citixen/pt2399_tap_euro/v1.1_control only.pdf

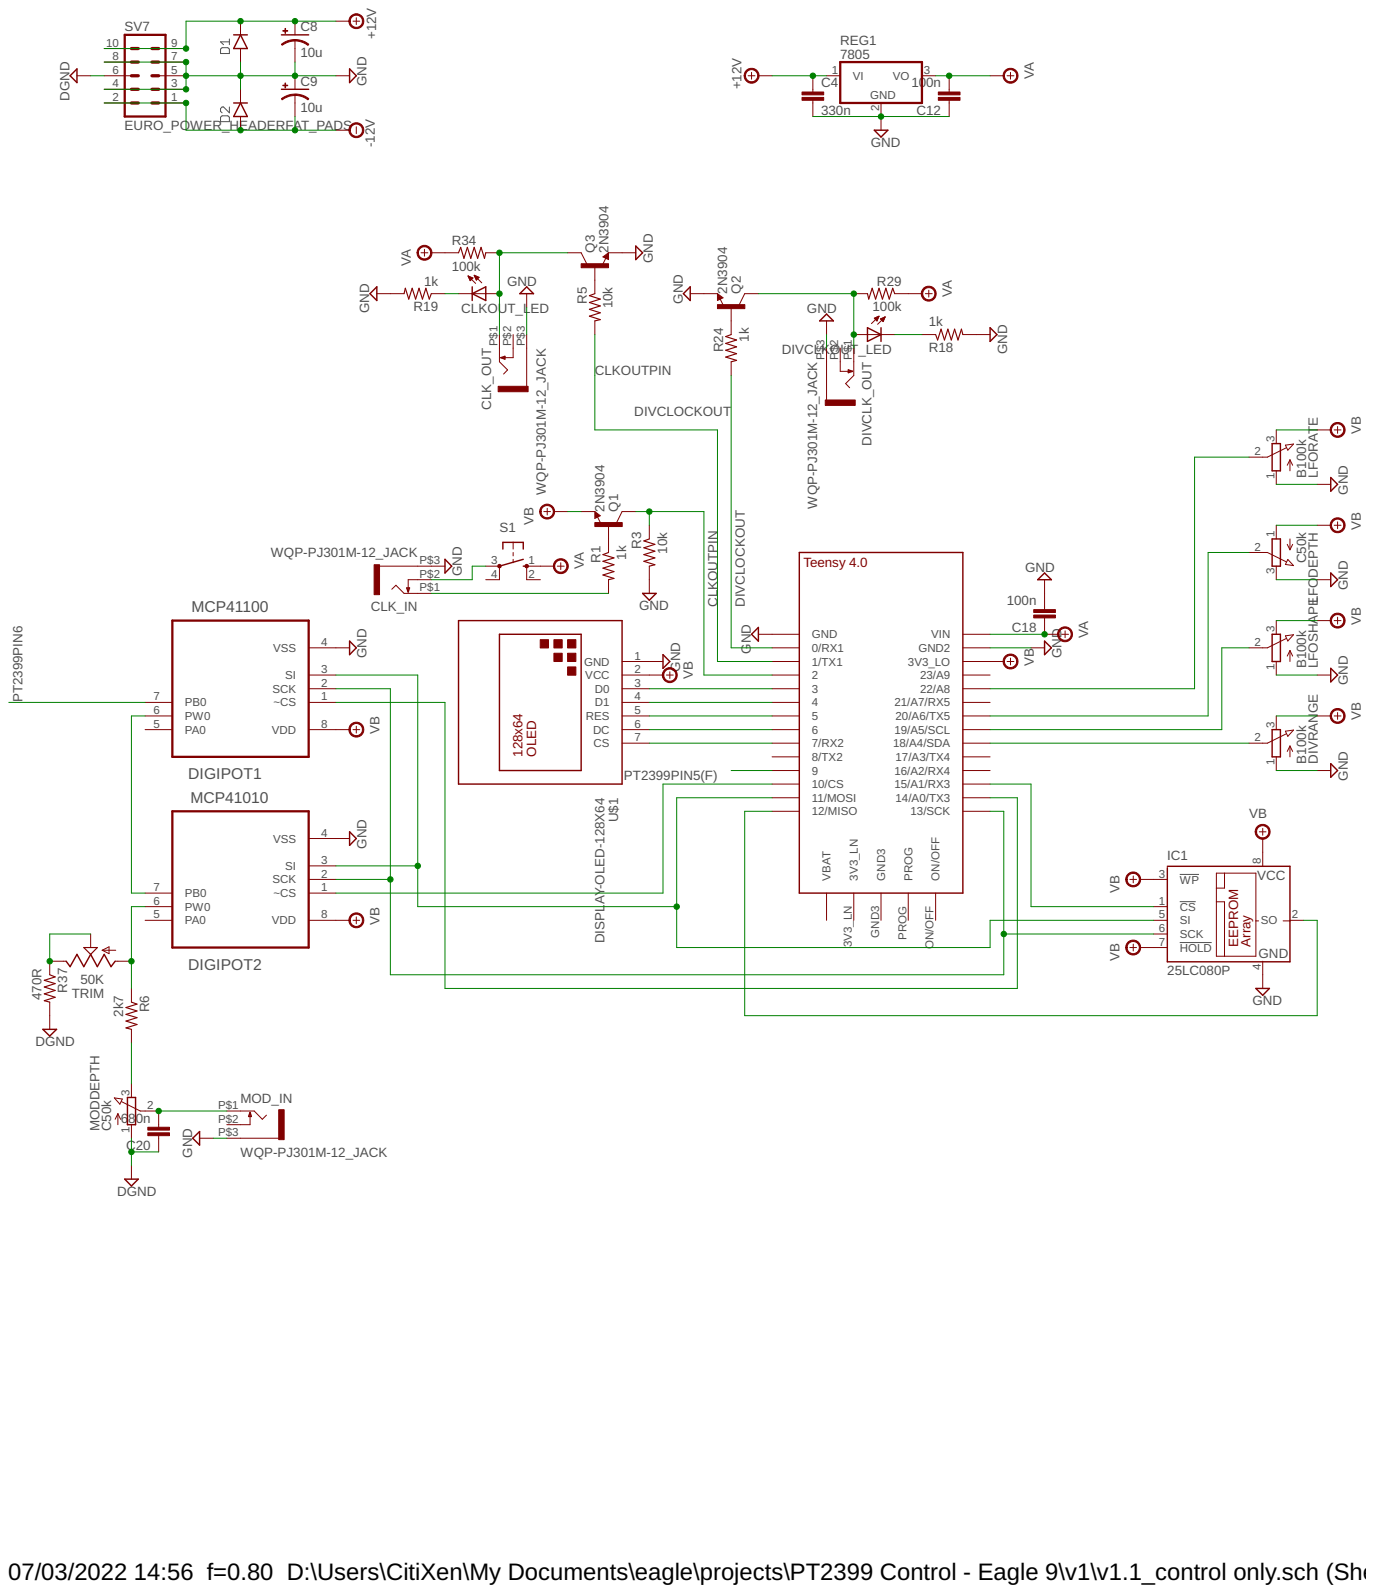
[picture p1: page 1]

ON/OFF

07/03/2022 14:56 f=0.80 D:\Users\CitiXen\My Documents\eagle\projects\PT2399 Control - Eagle 9\v1\v1.1_control only.sch (Sheet: 1/2)
