citixen/pt2399_tap_euro/v1.1_control only.sch

## EAGLE design v1.1_control only.sch (2022-03-07)

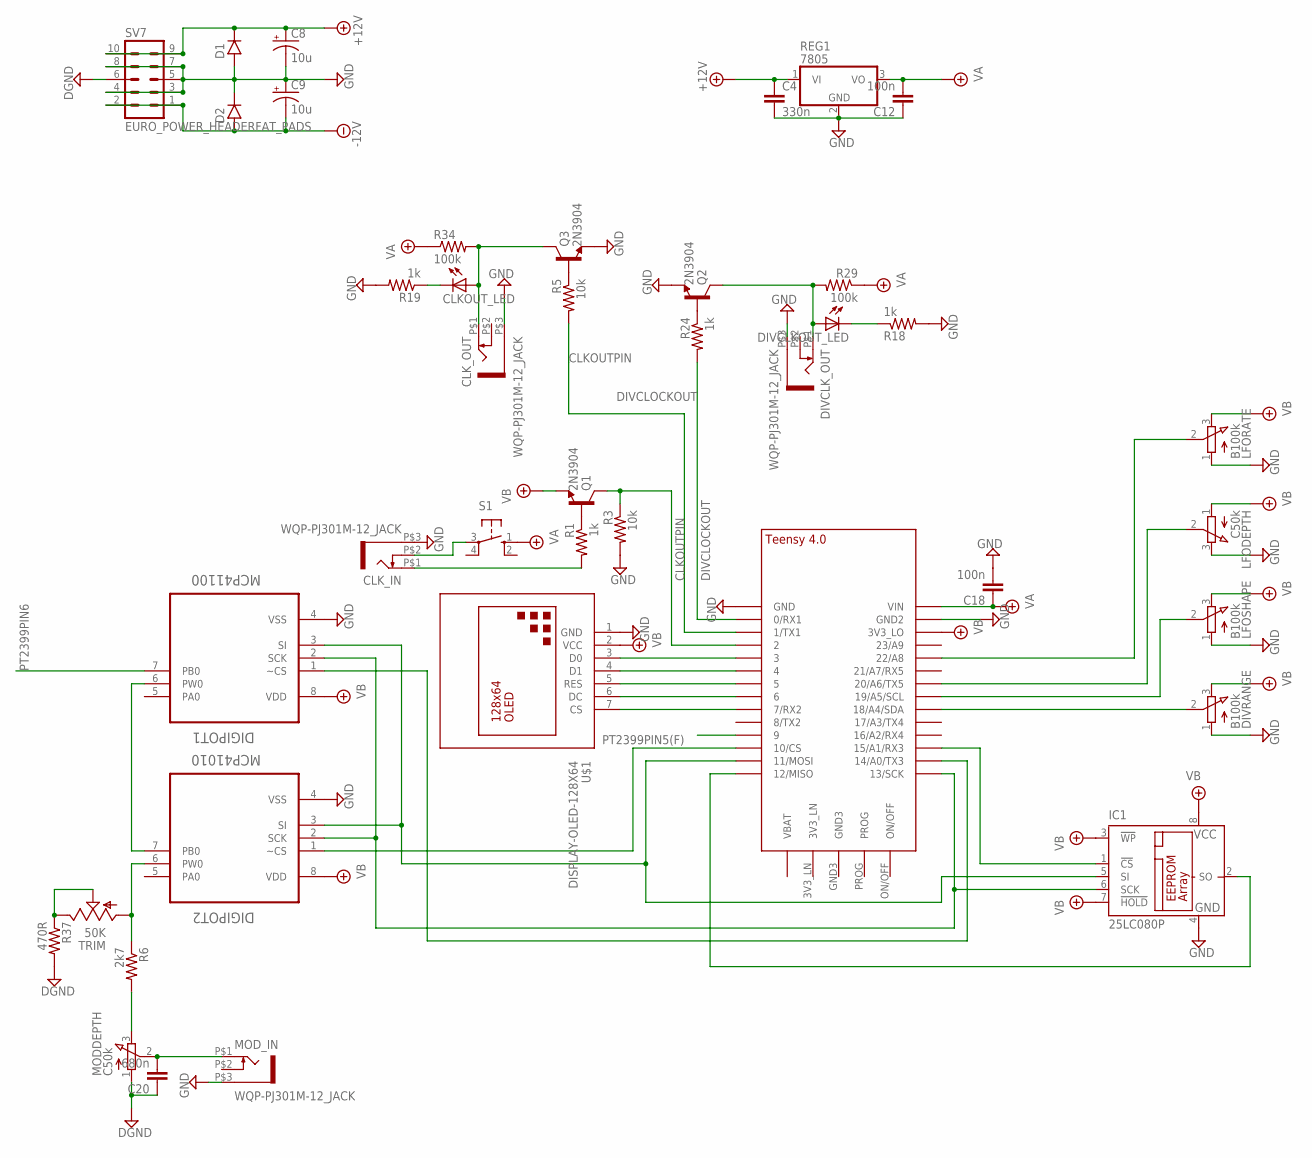
[picture p2: schematic v1.1_control only.sch, sheet 1]

Parts:
C4: 330n; 072X045
C8, C9: 10u; 050_020_1
C12, C18: 100n; 072X035
C20: 680n; 072X045
CLKOUT_LED: LED3MM
CLK_IN: WQP-PJ301M-12_JACK
CLK_OUT: WQP-PJ301M-12_JACK
D1, D2: 1N400X.3; DO41-3
DIGIPOT1: MCP41100; DIL08
DIGIPOT2: MCP41010; DIL08
DIVCLKOUT_LED: LED3MM
DIVCLK_OUT: WQP-PJ301M-12_JACK
DIVRANGE: B100k; EVUF
IC1: 25LC080P; DIL8
LFODEPTH: C50k; EVUF
LFORATE: B100k; EVUF
LFOSHAPE: B100k; EVUF
MODDEPTH: C50k; EVUF
MOD_IN: WQP-PJ301M-12_JACK
Q1, Q2, Q3: 2N3904; TO92-
R1, R18, R19, R24: 1k; R0207/3
R3, R5: 10k; R0207/3
R6: 2k7; R0207/3
R29, R34: 100k; R0207/3
R37: 470R; R0207/3
REG1: 7805; TO92-
S1: 10-XX; B3F-10XX
SV7: EURO_POWER_HEADERFAT_PADS; EURO_PWR_HEADER_FAT
TRIM: 50K; B64Y
U$1: DISPLAY-OLED-128X64
U$2: TEENSY_4.0-BASIC

Connections:
+12V: C4.1, C8.+, D1.C, REG1.1 (VI), SV7.9, SV7.10
-12V: C9.-, D2.A, SV7.1, SV7.2
CLKOUTPIN: R5.2, U$2.1/TX (1/TX1)
DGND: C20.1, MODDEPTH.1 (A), R37.2, SV7.6
DIVCLOCKOUT: R24.2, U$2.0/RX (0/RX1)
GND: C4.2, C8.-, C9.+, C12.1, C18.2, CLK_IN.P$3 (1), CLK_OUT.P$3 (1), D1.A, D2.C, DIGIPOT1.4 (VSS), DIGIPOT2.4 (VSS), DIVCLK_OUT.P$3 (1), DIVRANGE.1 (A), IC1.4 (GND), LFODEPTH.3 (E), LFORATE.1 (A), LFOSHAPE.1 (A), MOD_IN.P$3 (1), Q2.3 (E), Q3.3 (E), R3.2, R18.2, R19.2, REG1.2 (GND), SV7.3, SV7.4, SV7.5, SV7.7, SV7.8, U$1.1 (GND), U$2.GND, U$2.GND2
unnamed: LFORATE.2 (S), U$2.22/A8
unnamed: DIGIPOT1.6 (PW0), DIGIPOT2.7 (PB0)
unnamed: LFODEPTH.2 (S), U$2.20/A6 (20/A6/TX5)
unnamed: LFOSHAPE.2 (S), U$2.19/A5/SCL
unnamed: DIGIPOT1.2 (SCK), DIGIPOT2.2 (SCK), IC1.6 (SCK), U$2.13/SCK
unnamed: U$1.3 (D0), U$2.3/CANTX (3)
unnamed: IC1.1 (!CS), U$2.15/A1 (15/A1/RX3)
unnamed: DIGIPOT1.3 (SI), DIGIPOT2.3 (SI), IC1.5 (SI), U$2.11/MOSI
unnamed: Q1.1 (C), R3.1, U$2.2
unnamed: DIGIPOT2.1 (~CS), U$2.10/CS
unnamed: IC1.2 (SO), U$2.12/MISO
unnamed: DIVCLKOUT_LED.K (C), R18.1
unnamed: DIGIPOT1.1 (~CS), U$2.14/A0 (14/A0/TX3)
unnamed: CLKOUT_LED.K (C), R19.1
unnamed: U$1.4 (D1), U$2.4/CANRX (4)
unnamed: DIVRANGE.2 (S), U$2.18/A4/SDA
unnamed: CLK_IN.P$2 (3), S1.3
unnamed: C20.2, MODDEPTH.2 (S), MOD_IN.P$1 (2)
unnamed: Q3.2 (B), R5.1
unnamed: U$1.5 (RES), U$2.5
unnamed: Q1.2 (B), R1.1
unnamed: Q2.2 (B), R24.1
unnamed: DIVCLKOUT_LED.A, DIVCLK_OUT.P$1 (2), Q2.1 (C), R29.2
unnamed: CLKOUT_LED.A, CLK_OUT.P$1 (2), Q3.1 (C), R34.2
unnamed: CLK_IN.P$1 (2), R1.2
unnamed: MODDEPTH.3 (E), R6.2
unnamed: U$1.6 (DC), U$2.6
unnamed: U$1.7 (CS), U$2.7 (7/RX2)
unnamed: DIGIPOT2.6 (PW0), R6.1, TRIM.A
unnamed: R37.1, TRIM.E, TRIM.S
PT2399PIN5(F): U$2.9/CS (9)
PT2399PIN6: DIGIPOT1.7 (PB0)
VA: C12.2, C18.1, R29.1, R34.1, REG1.3 (VO), S1.1 (S), U$2.VIN
VB: DIGIPOT1.8 (VDD), DIGIPOT2.8 (VDD), DIVRANGE.3 (E), IC1.3 (!WP), IC1.7 (!HOLD), IC1.8 (VCC), LFODEPTH.1 (A), LFORATE.3 (E), LFOSHAPE.3 (E), Q1.3 (E), U$1.2 (VCC), U$2.3V3_LO
