citixen/pt2399_tap_euro/wavtables.h

const PROGMEM signed char SinTable[]=
{
	0,	//0
	3,	//1
	6,	//2
	9,	//3
	12,	//4
	15,	//5
	18,	//6
	21,	//7
	24,	//8
	27,	//9
	30,	//10
	33,	//11
	36,	//12
	39,	//13
	42,	//14
	45,	//15
	48,	//16
	51,	//17
	54,	//18
	57,	//19
	59,	//20
	62,	//21
	65,	//22
	67,	//23
	70,	//24
	73,	//25
	75,	//26
	78,	//27
	80,	//28
	82,	//29
	85,	//30
	87,	//31
	89,	//32
	91,	//33
	94,	//34
	96,	//35
	98,	//36
	100,	//37
	102,	//38
	103,	//39
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
};

const PROGMEM signed char TriangleTable[]=
{
	0,	//0
	1,	//1
	3,	//2
	5,	//3
	7,	//4
	9,	//5
	11,	//6
	13,	//7
	15,	//8
	17,	//9
	19,	//10
	21,	//11
	23,	//12
	25,	//13
	27,	//14
	29,	//15
	31,	//16
	33,	//17
	35,	//18
	37,	//19
	39,	//20
	41,	//21
	43,	//22
	45,	//23
	47,	//24
	49,	//25
	51,	//26
	53,	//27
	55,	//28
	57,	//29
	59,	//30
	61,	//31
	63,	//32
	65,	//33
	67,	//34
	69,	//35
	71,	//36
	73,	//37
	75,	//38
	77,	//39
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
};

const PROGMEM signed char SquareTable[]=
{
	127,	//0
	127,	//1
	127,	//2
	127,	//3
	127,	//4
	127,	//5
	127,	//6
	127,	//7
	127,	//8
	127,	//9
	127,	//10
	127,	//11
	127,	//12
	127,	//13
	127,	//14
	127,	//15
	127,	//16
	127,	//17
	127,	//18
	127,	//19
	127,	//20
	127,	//21
	127,	//22
	127,	//23
	127,	//24
	127,	//25
	127,	//26
	127,	//27
	127,	//28
	127,	//29
	127,	//30
	127,	//31
	127,	//32
	127,	//33
	127,	//34
	127,	//35
	127,	//36
	127,	//37
	127,	//38
	127,	//39
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
};
const PROGMEM signed char SawTable[]=
{
	127,	//1
	126,	//2
	125,	//3
	124,	//4
	123,	//5
	122,	//6
	121,	//7
	120,	//8
	119,	//9
	118,	//10
	117,	//11
	116,	//12
	115,	//13
	114,	//14
	113,	//15
	112,	//16
	111,	//17
	110,	//18
	109,	//19
	108,	//20
	107,	//21
	106,	//22
	105,	//23
	104,	//24
	103,	//25
	102,	//26
	101,	//27
	100,	//28
	99,	//29
	98,	//30
	97,	//31
	96,	//32
	95,	//33
	94,	//34
	93,	//35
	92,	//36
	91,	//37
	90,	//38
	89,	//39
	88,	//40
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
};
const PROGMEM signed char RampTable[]=
{
	-127,	//0
	-126,	//1
	-125,	//2
	-124,	//3
	-123,	//4
	-122,	//5
	-121,	//6
	-120,	//7
	-119,	//8
	-118,	//9
	-117,	//10
	-116,	//11
	-115,	//12
	-114,	//13
	-113,	//14
	-112,	//15
	-111,	//16
	-110,	//17
	-109,	//18
	-108,	//19
	-107,	//20
	-106,	//21
	-105,	//22
	-104,	//23
	-103,	//24
	-102,	//25
	-101,	//26
	-100,	//27
	-99,	//28
	-98,	//29
	-97,	//30
	-96,	//31
	-95,	//32
	-94,	//33
	-93,	//34
	-92,	//35
	-91,	//36
	-90,	//37
	-89,	//38
	-88,	//39
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
};
const PROGMEM signed char NoiseTable[]=
{
	-62,	//0
	-72,	//1
	-92,	//2
	-98,	//3
	98,	//4
	-103,	//5
	96,	//6
	-89,	//7
	-29,	//8
	-55,	//9
	98,	//10
	-8,	//11
	-118,	//12
	13,	//13
	11,	//14
	-1,	//15
	76,	//16
	-8,	//17
	-116,	//18
	51,	//19
	33,	//20
	-85,	//21
	-43,	//22
	-16,	//23
	-114,	//24
	-47,	//25
	-63,	//26
	-113,	//27
	109,	//28
	-39,	//29
	-127,	//30
	-59,	//31
	0,	//32
	118,	//33
	70,	//34
	62,	//35
	54,	//36
	85,	//37
	51,	//38
	122,	//39
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
};

//Table to give divisors for depth calcs
const PROGMEM float DepthTable[]=
{
  1.0,
  1.5,
2.0,
2.5,
3.0,
3.5,
4.0,
5.0,
6.0,
7.0,
8.0,
9.0,
10.0,
11.0,
12.0,
13.0,
14.0,
15.0,
16.0,
18.0,
20.0,
22.0,
24.0,
26.0,
28.0,
30.0,
33.0,
38.0,
41.0,
44.0,
47.0,
50.0,
54.0,
58.0,
62.0,
66.0,
70.0,
75.0,
80.0,
90.0,
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

};
