citixen/pt2399_tap_euro/(notices)

Notices in the files:
parts and their libraries:
SSD1306: Released under the Creative Commons Attribution 4.0 International License: http://creativecommons.org/licenses/by/4.0
